RoboticsClubIITJ/painting-arm/Comparison/Result.png

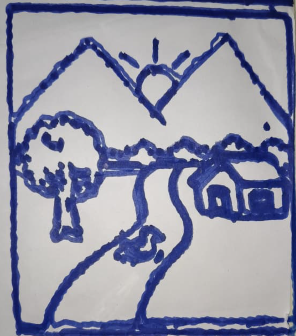
Comparison/Result.png
