RoboticsClubIITJ/painting-arm/Comparison/Original.png

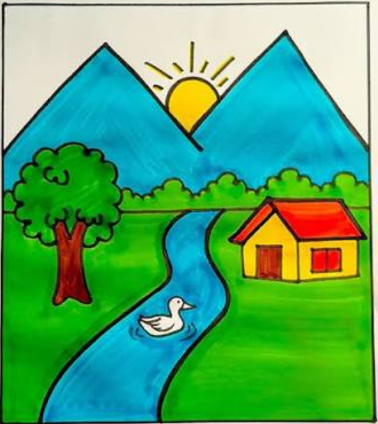
Comparison/Original.png
