RoboticsClubIITJ/painting-arm/Comparison/GUI.png

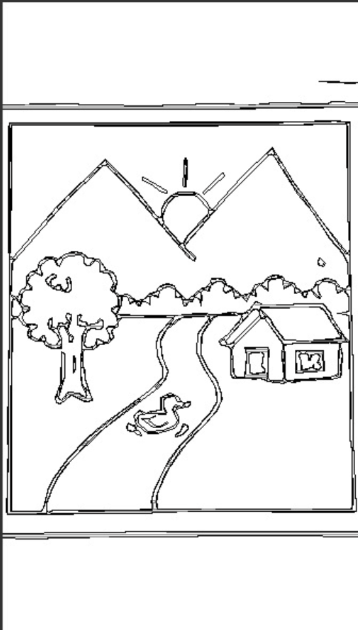
Comparison/GUI.png
