RoboticsClubIITJ/painting-arm/CAD Model/BoBRoss Assembly.step

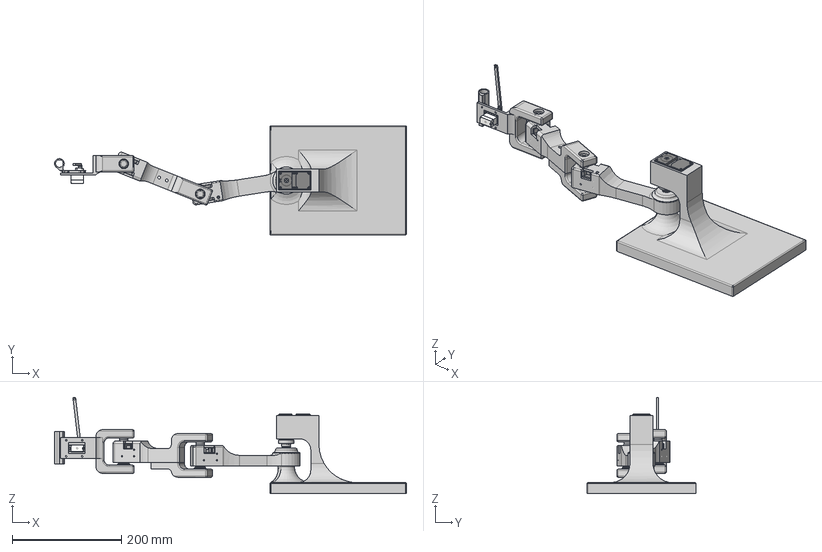
[picture p8: CAD file, 2026-10-04]
CAD Model/BoBRoss Assembly.step
644.3 x 200.0 x 175.9 mm
