RoboticsClubIITJ/painting-arm/CAD Model/Printables/link2p2.stl

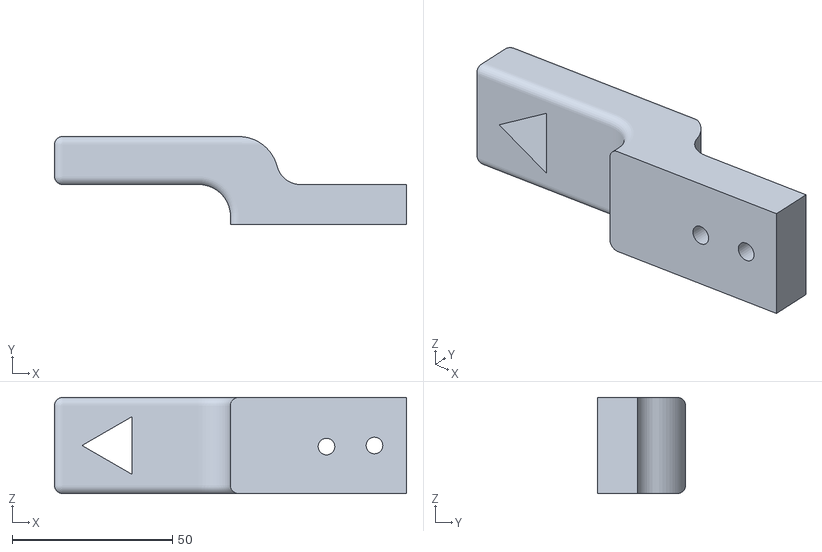
[picture p9: CAD file, 2026-10-04]
CAD Model/Printables/link2p2.stl
110.0 x 27.5 x 30.0
