RoboticsClubIITJ/painting-arm/CAD Model/Printables/Servo_head_xm430.stl

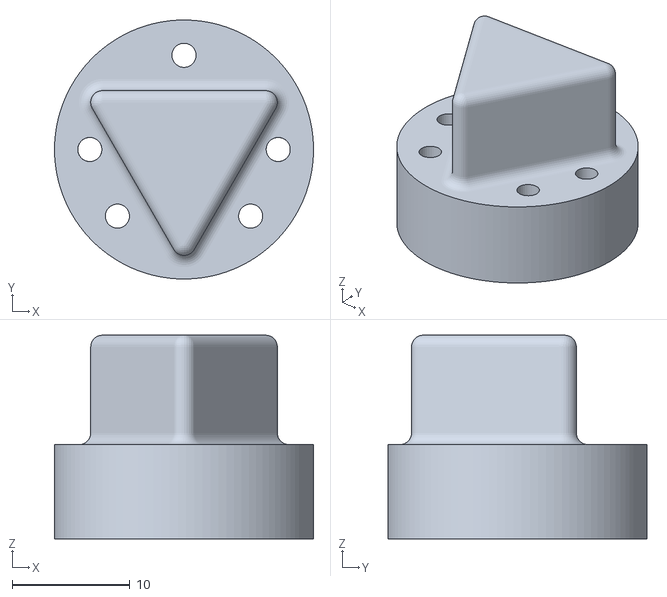
[picture p10: CAD file, 2026-10-04]
CAD Model/Printables/Servo_head_xm430.stl
22.0 x 22.0 x 17.3
