RoboticsClubIITJ/painting-arm/CAD Model/Printables/end effector.stl

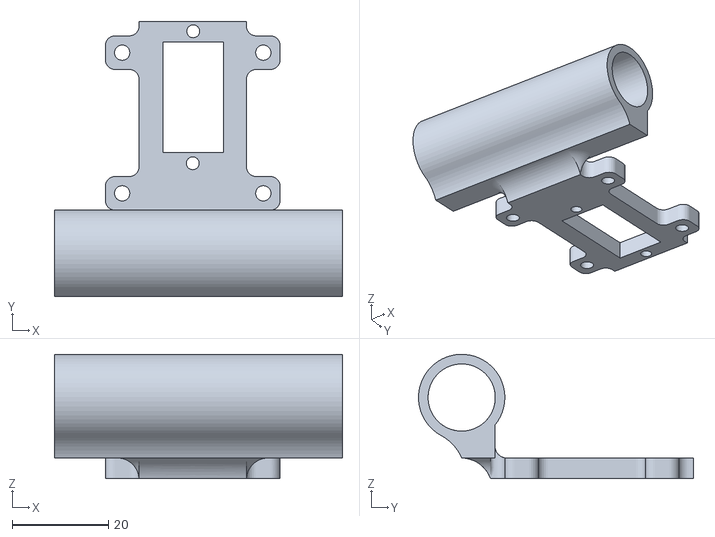
[picture p11: CAD file, 2026-10-04]
CAD Model/Printables/end effector.stl
60.0 x 57.3 x 25.9
