RoboticsClubIITJ/painting-arm/CAD Model/Printables/servo head.stl

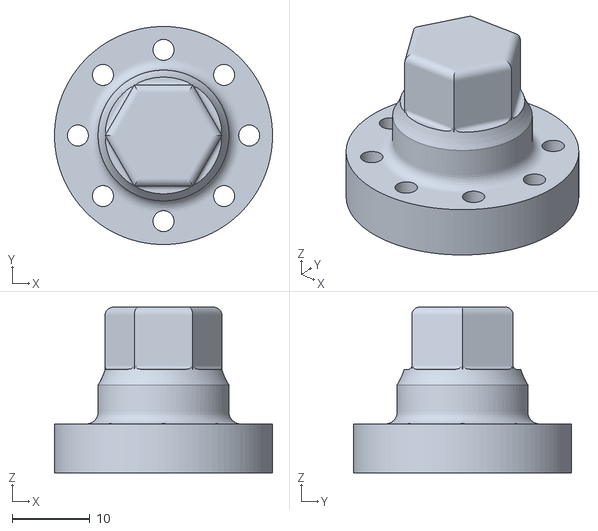
[picture p12: CAD file, 2026-10-04]
CAD Model/Printables/servo head.stl
28.0 x 28.0 x 21.3
