RoboticsClubIITJ/painting-arm/CAD Model/Printables/link2p1.stl

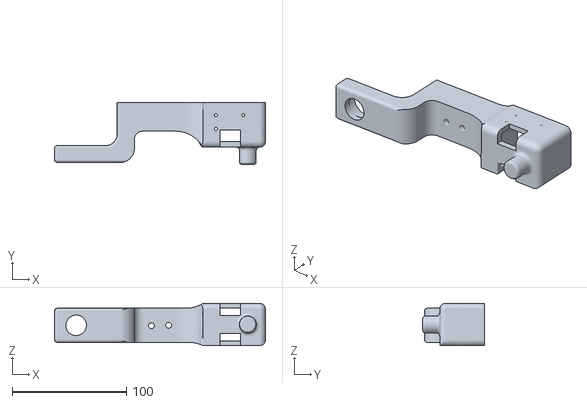
[picture p13: CAD file, 2026-10-04]
CAD Model/Printables/link2p1.stl
185.0 x 54.0 x 37.0
