RoboticsClubIITJ/painting-arm/CAD Model/Printables/base2.stl

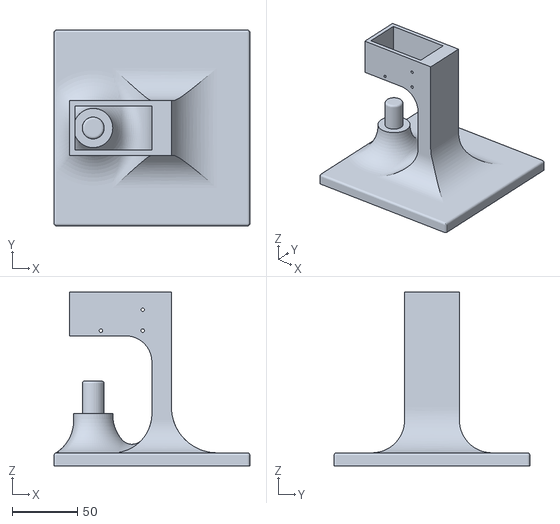
[picture p14: CAD file, 2026-10-04]
CAD Model/Printables/base2.stl
150.0 x 150.0 x 133.0
