RoboticsClubIITJ/painting-arm/CAD Model/Printables/link3p1.stl

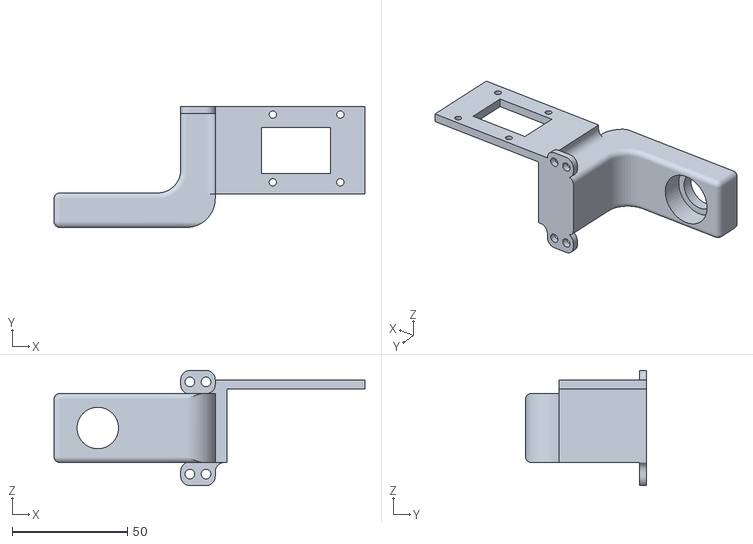
[picture p15: CAD file, 2026-10-04]
CAD Model/Printables/link3p1.stl
135.0 x 52.5 x 50.0
