RoboticsClubIITJ/painting-arm/CAD Model/Printables/link1.stl

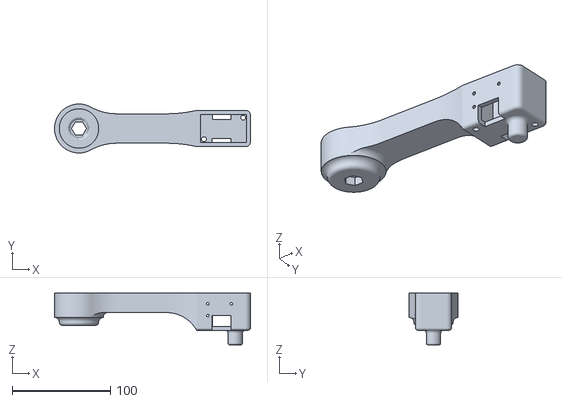
[picture p16: CAD file, 2026-10-04]
CAD Model/Printables/link1.stl
200.0 x 50.0 x 53.0
