RoboticsClubIITJ/painting-arm/CAD Model/Printables/link3p2.stl

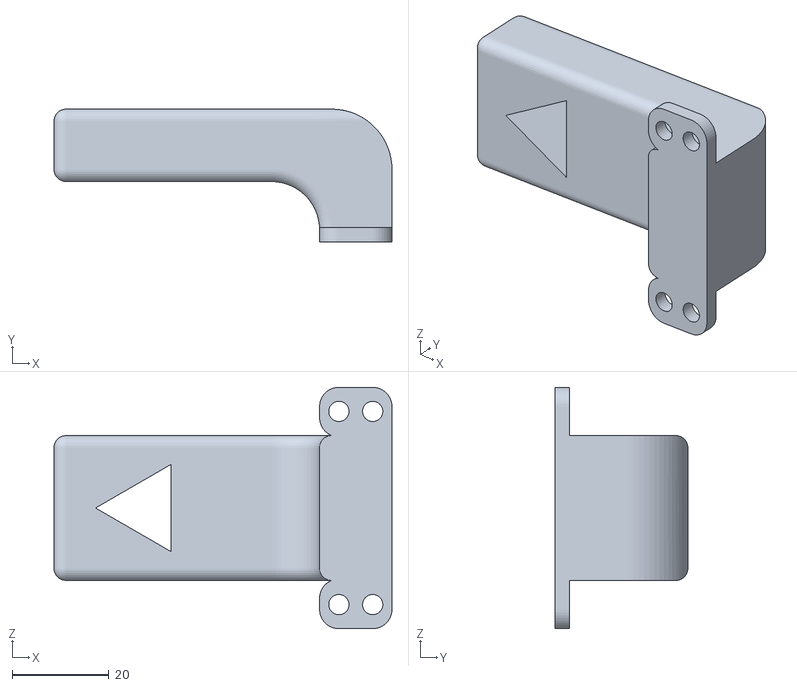
[picture p17: CAD file, 2026-10-04]
CAD Model/Printables/link3p2.stl
70.0 x 27.5 x 50.0
