RoboticsClubIITJ/painting-arm/(list of files, cad)

Other CAD files:
CAD Model/BoBRoss Assembly.f3z
