RoboticsClubIITJ/painting-arm/GradientDescentBasedIK.pdf

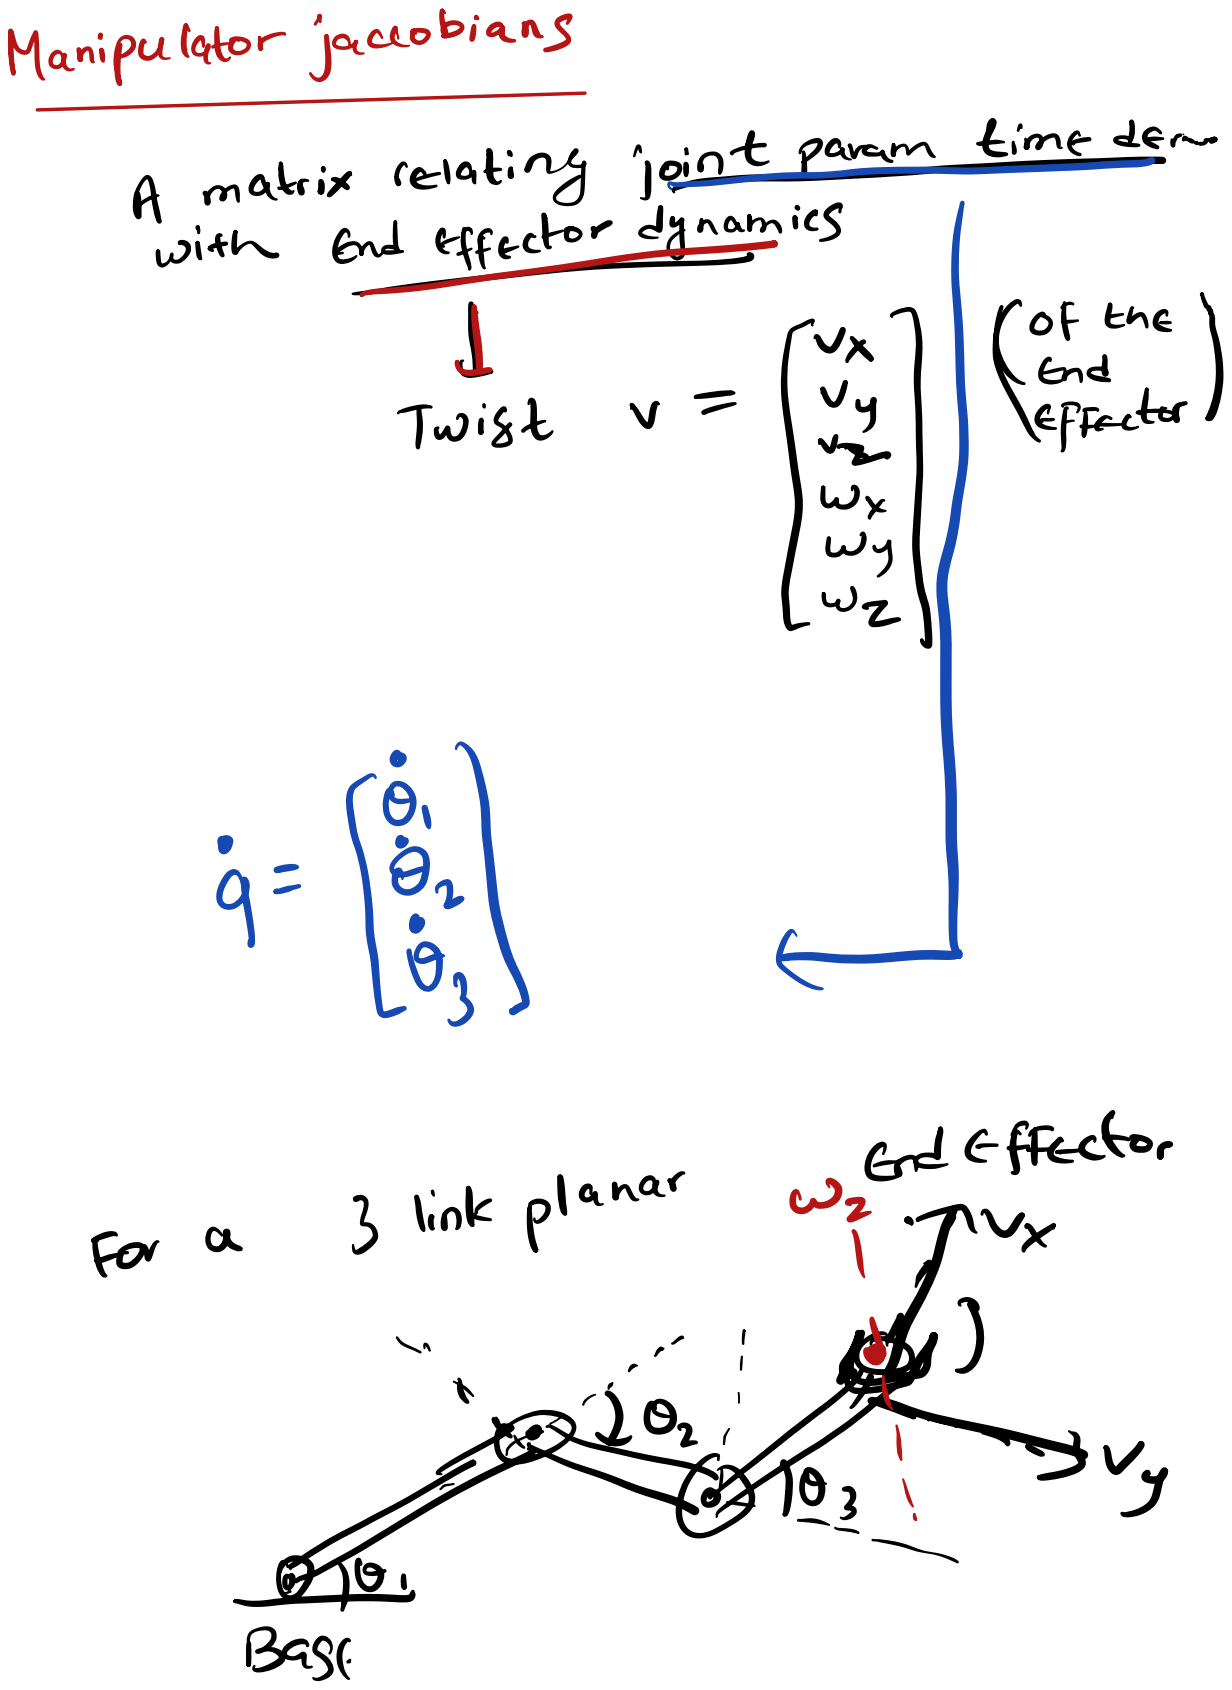
[picture p18: page 1]

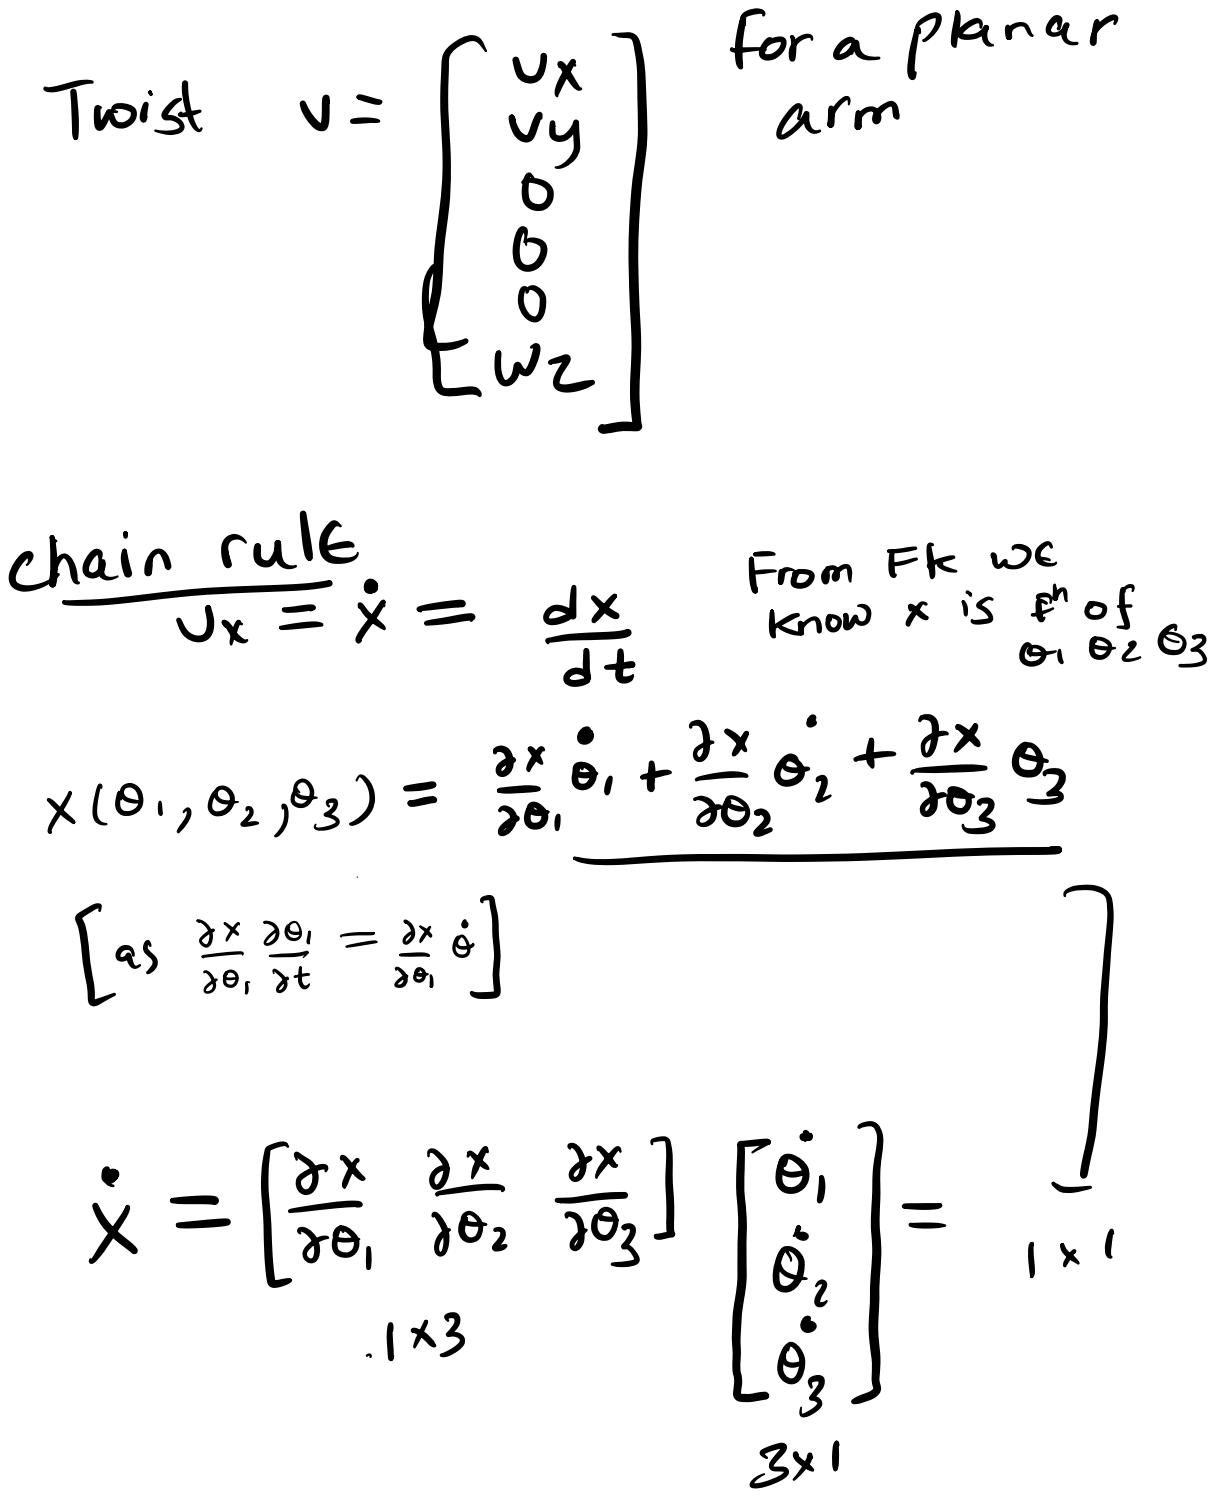
[picture p19: page 2]

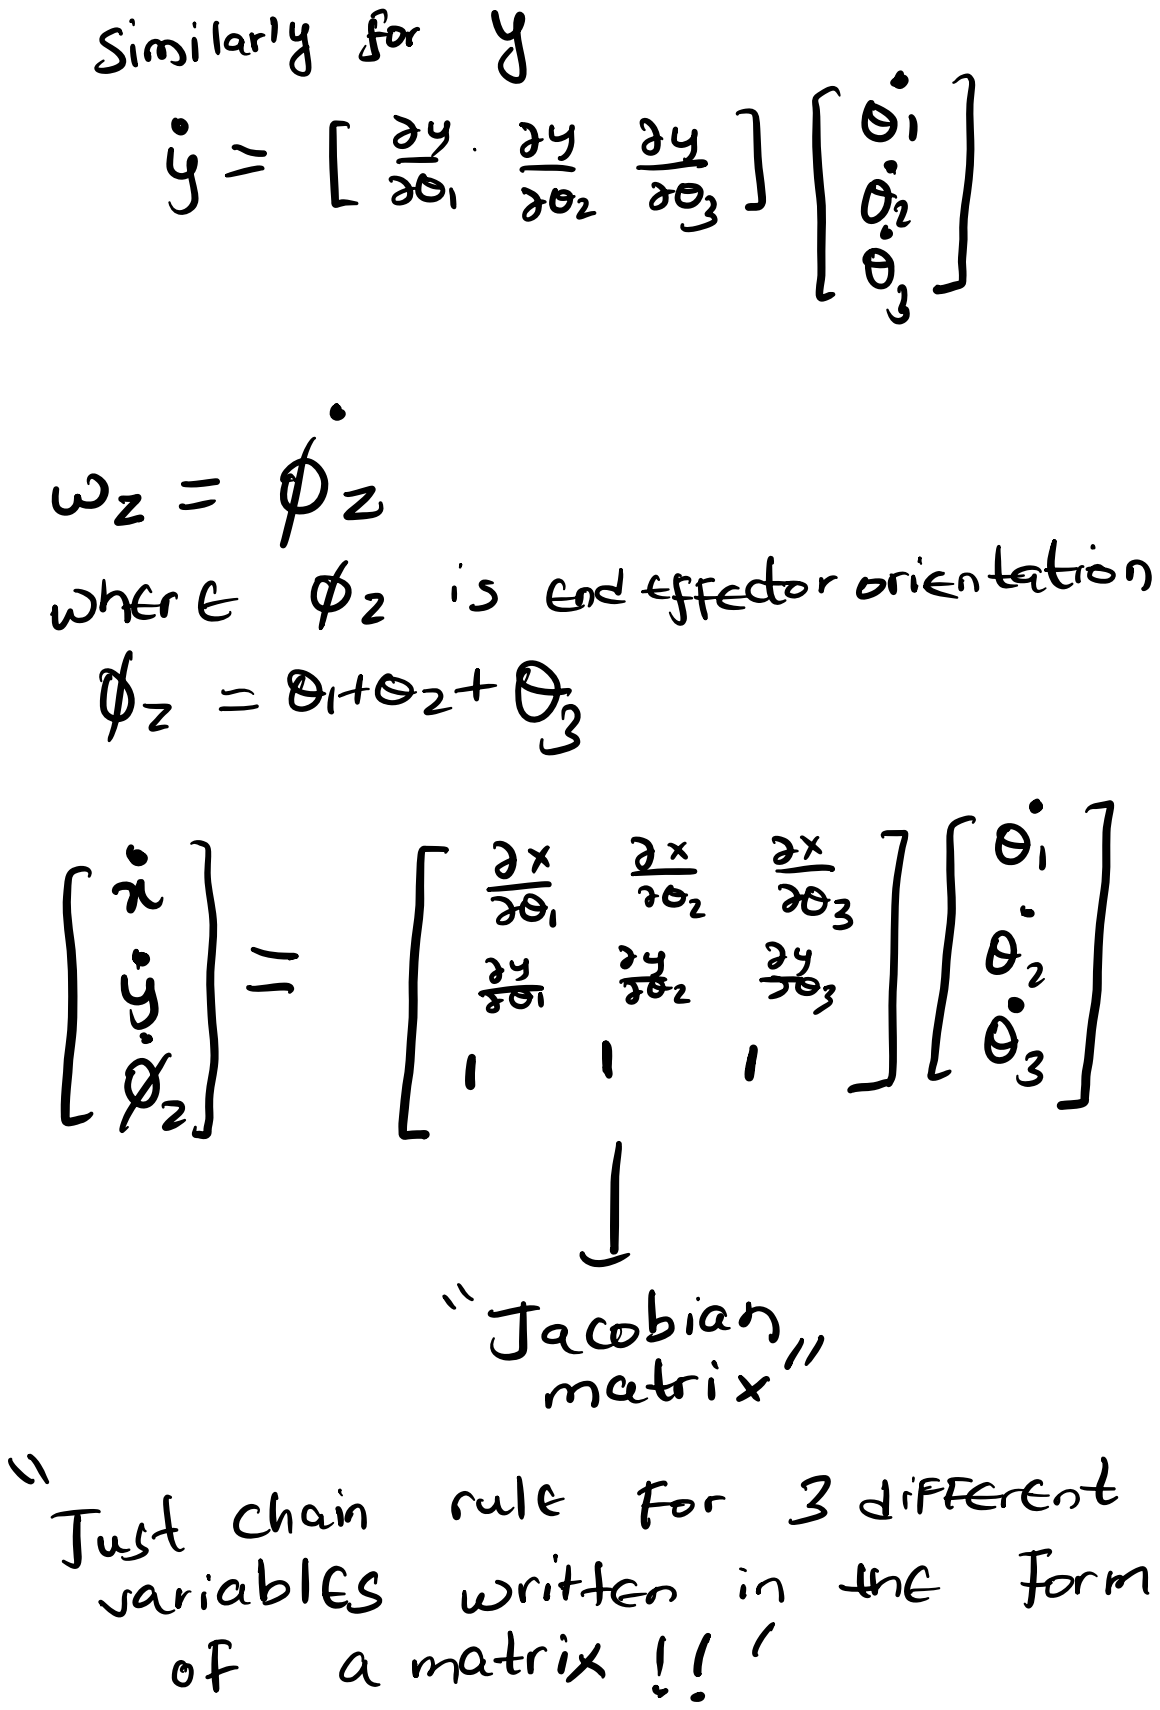
[picture p20: page 3]

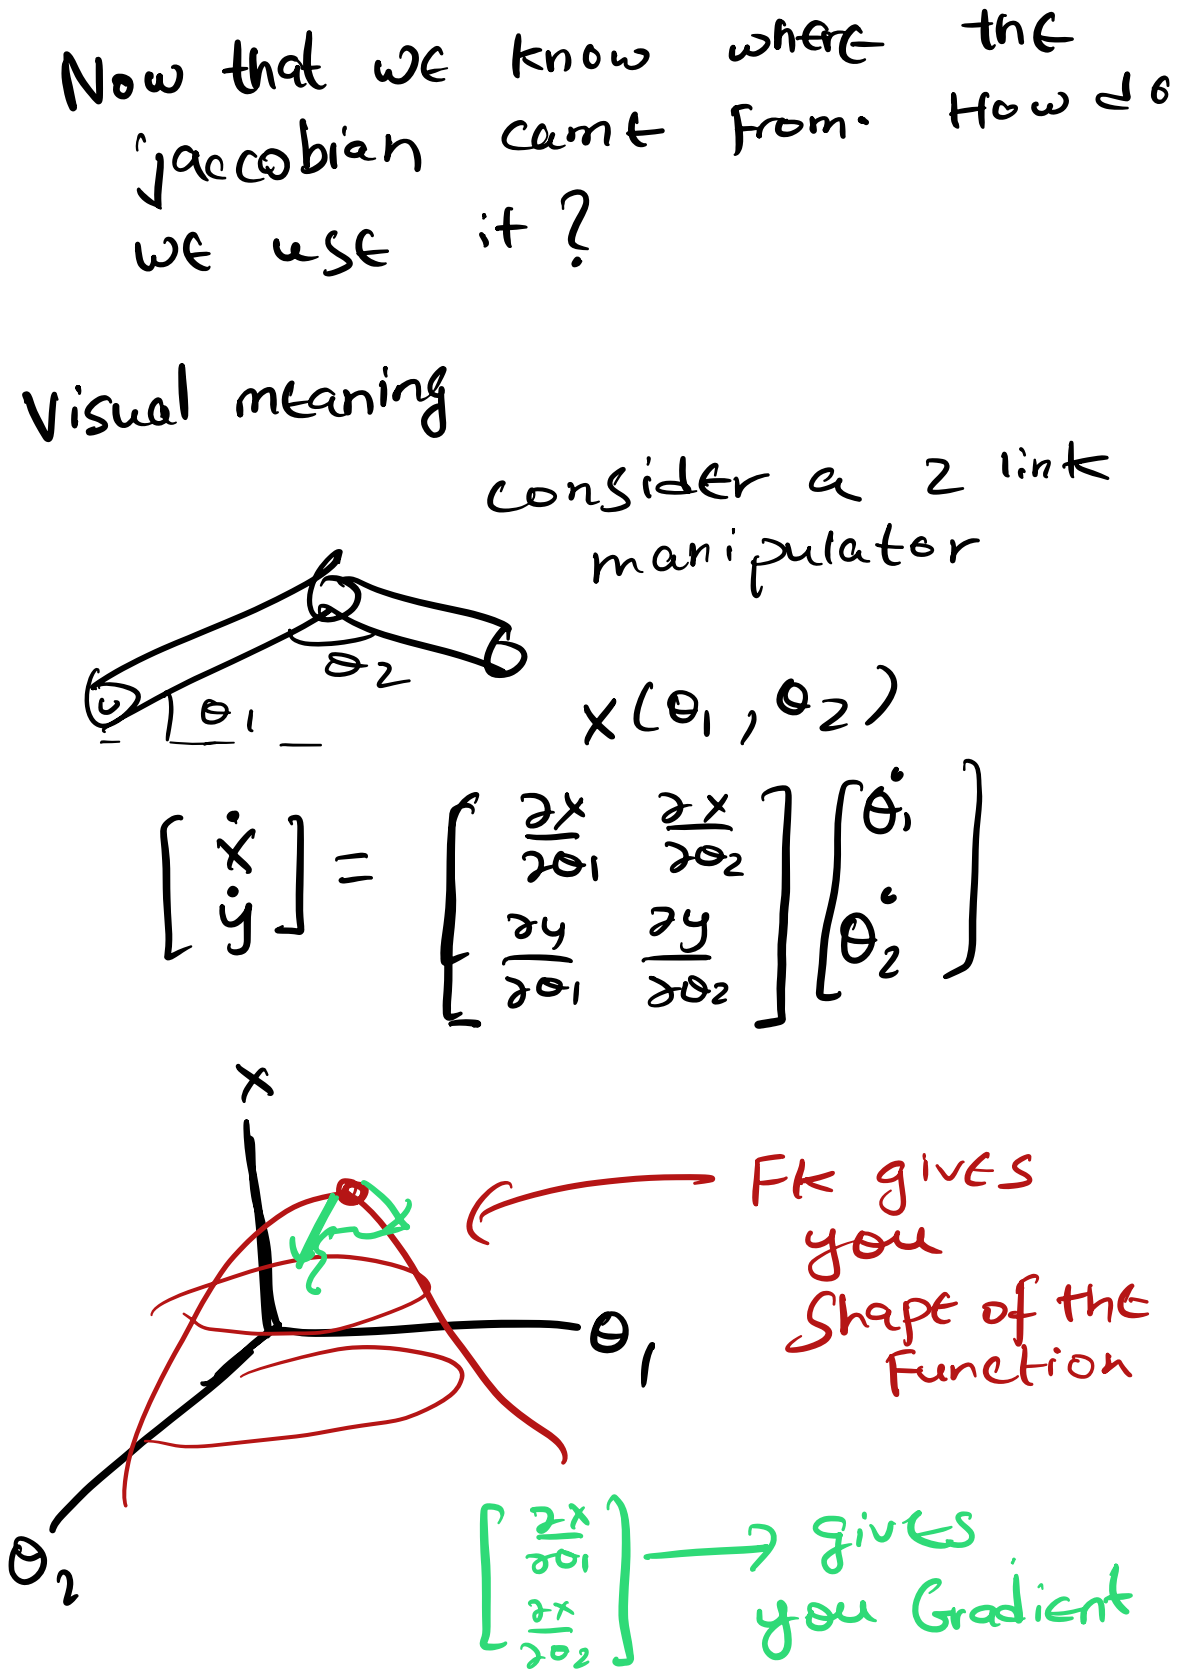
[picture p21: page 4]

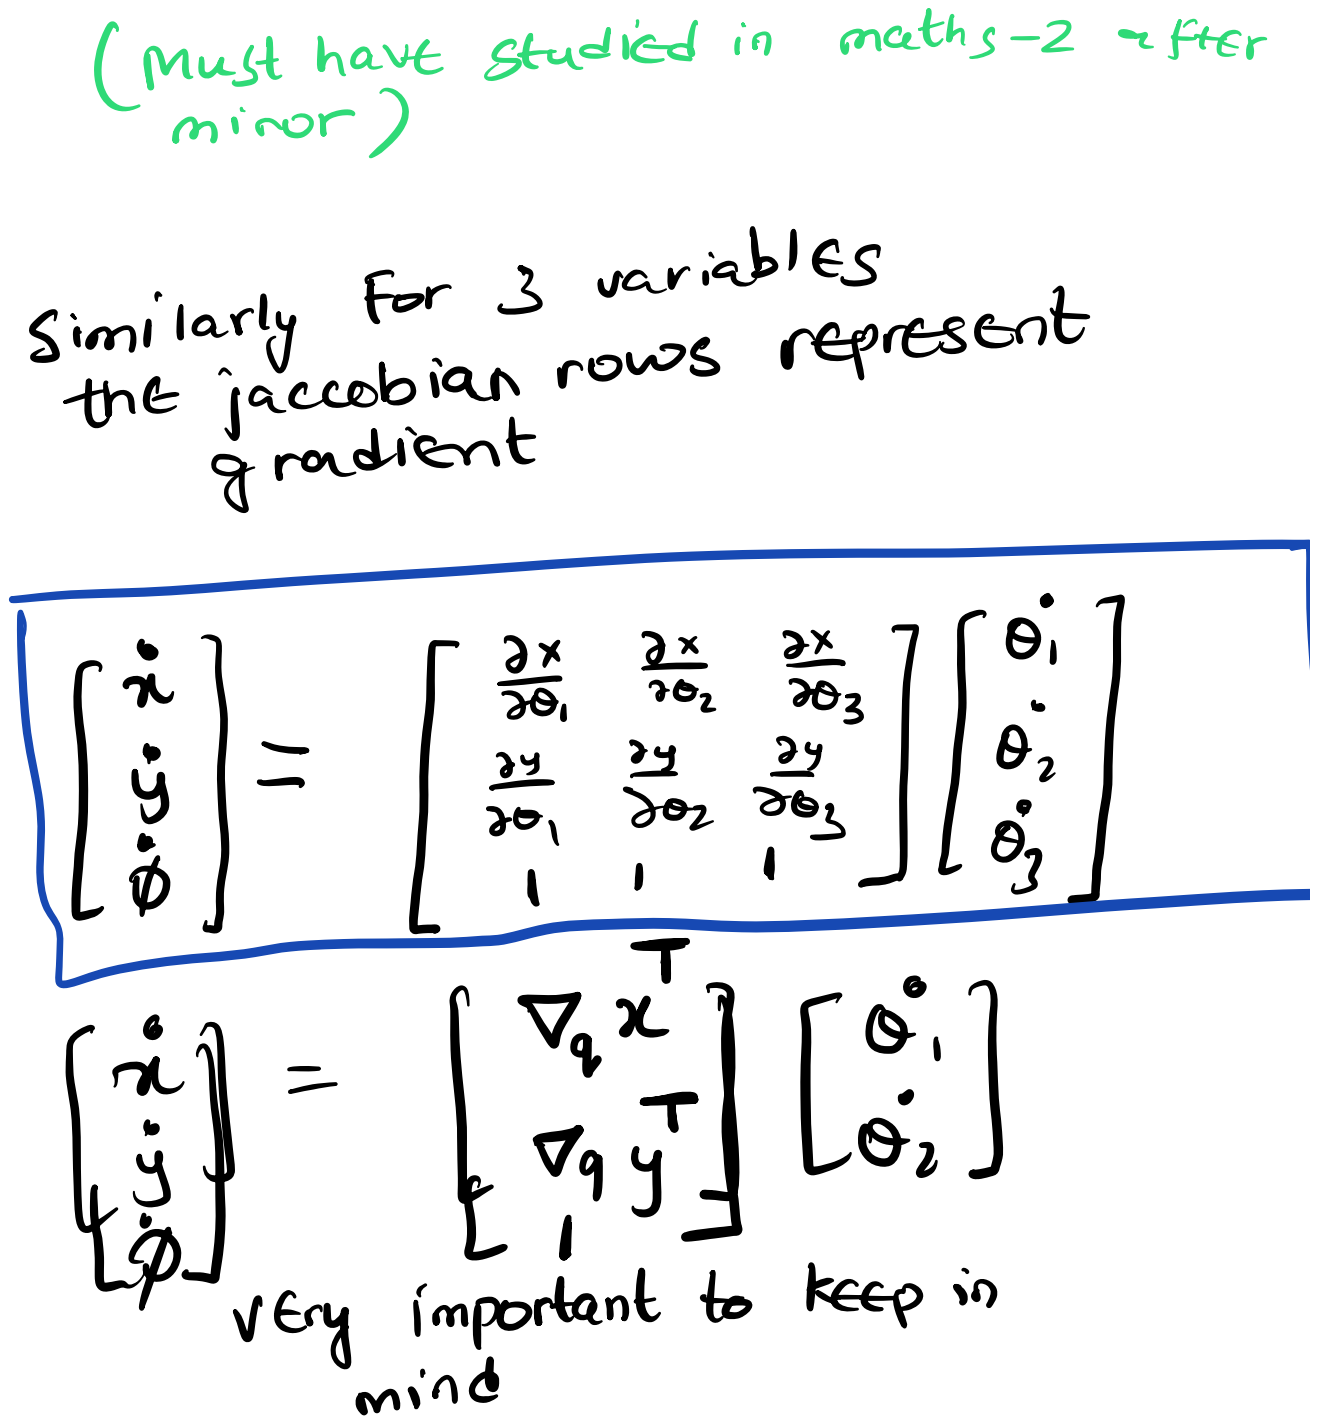
[picture p22: page 5]

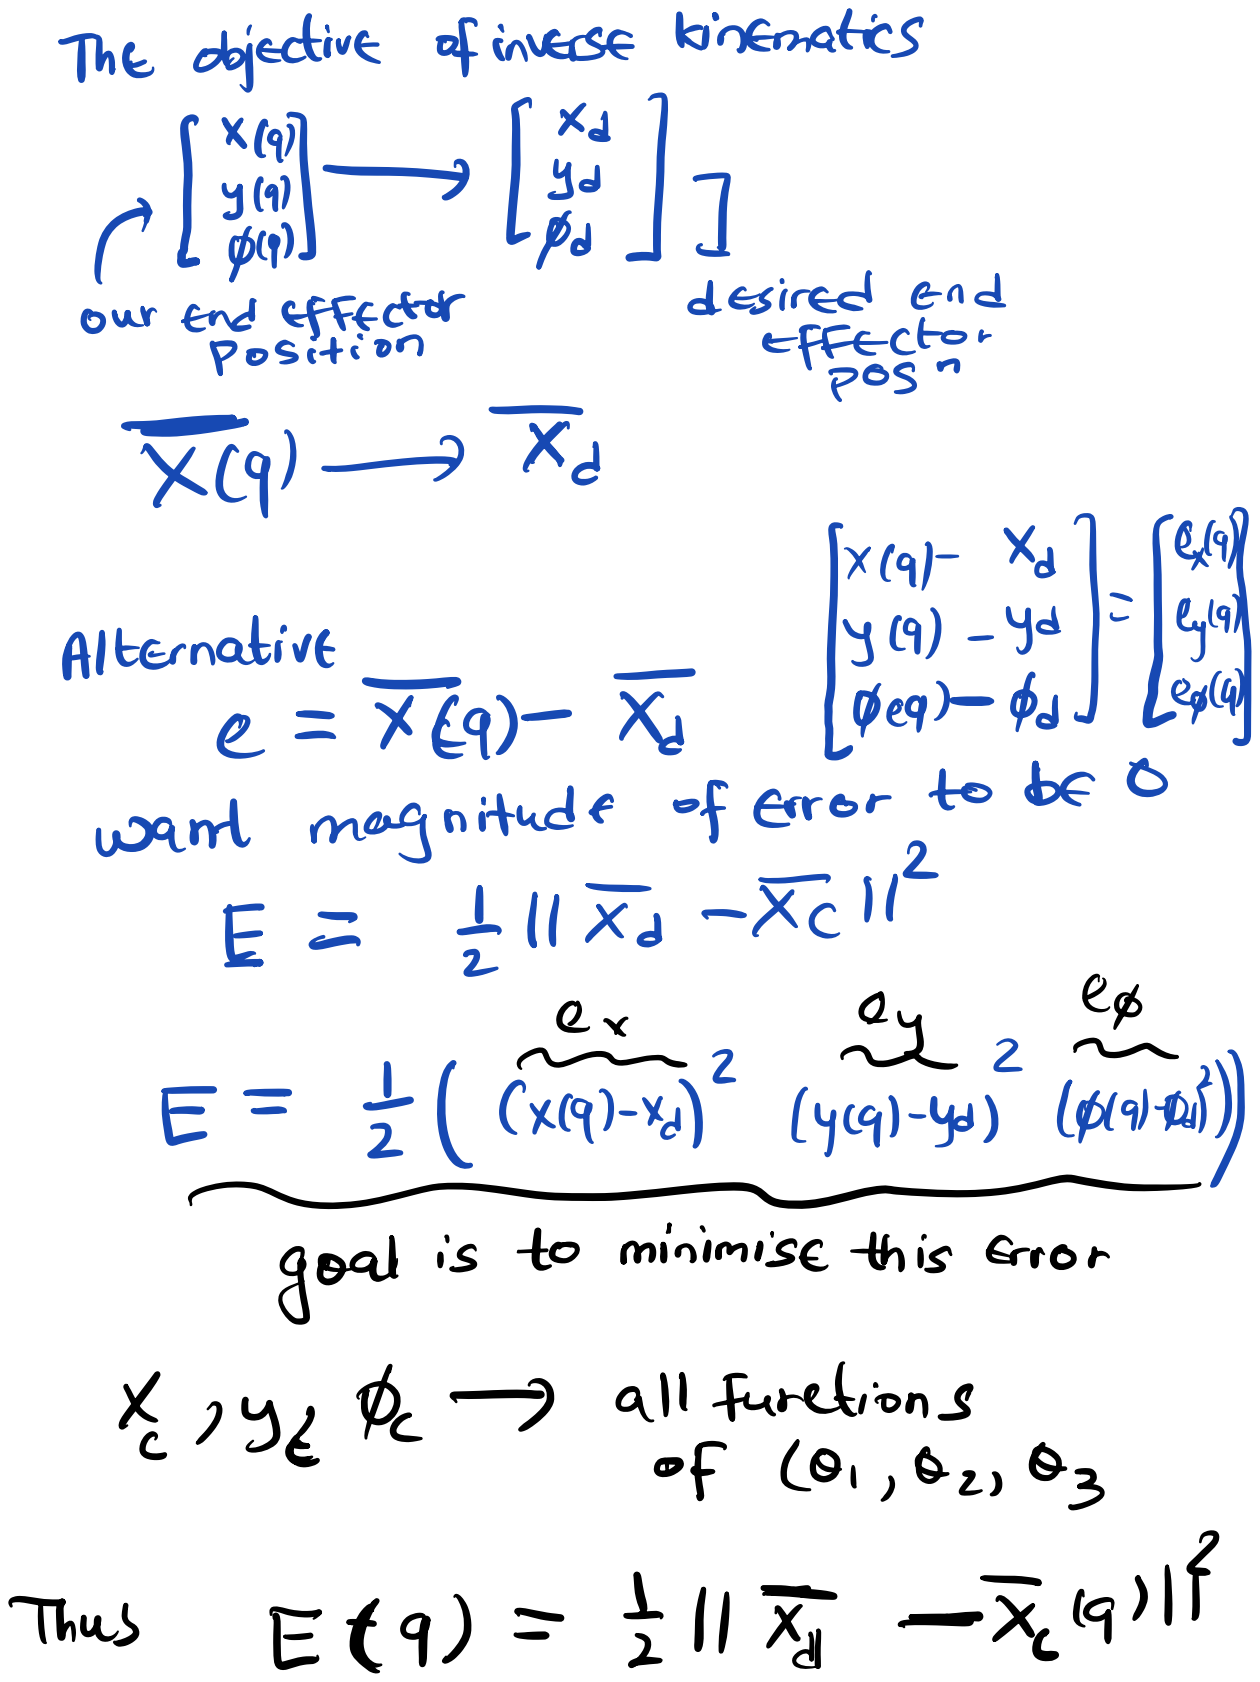
[picture p23: page 6]

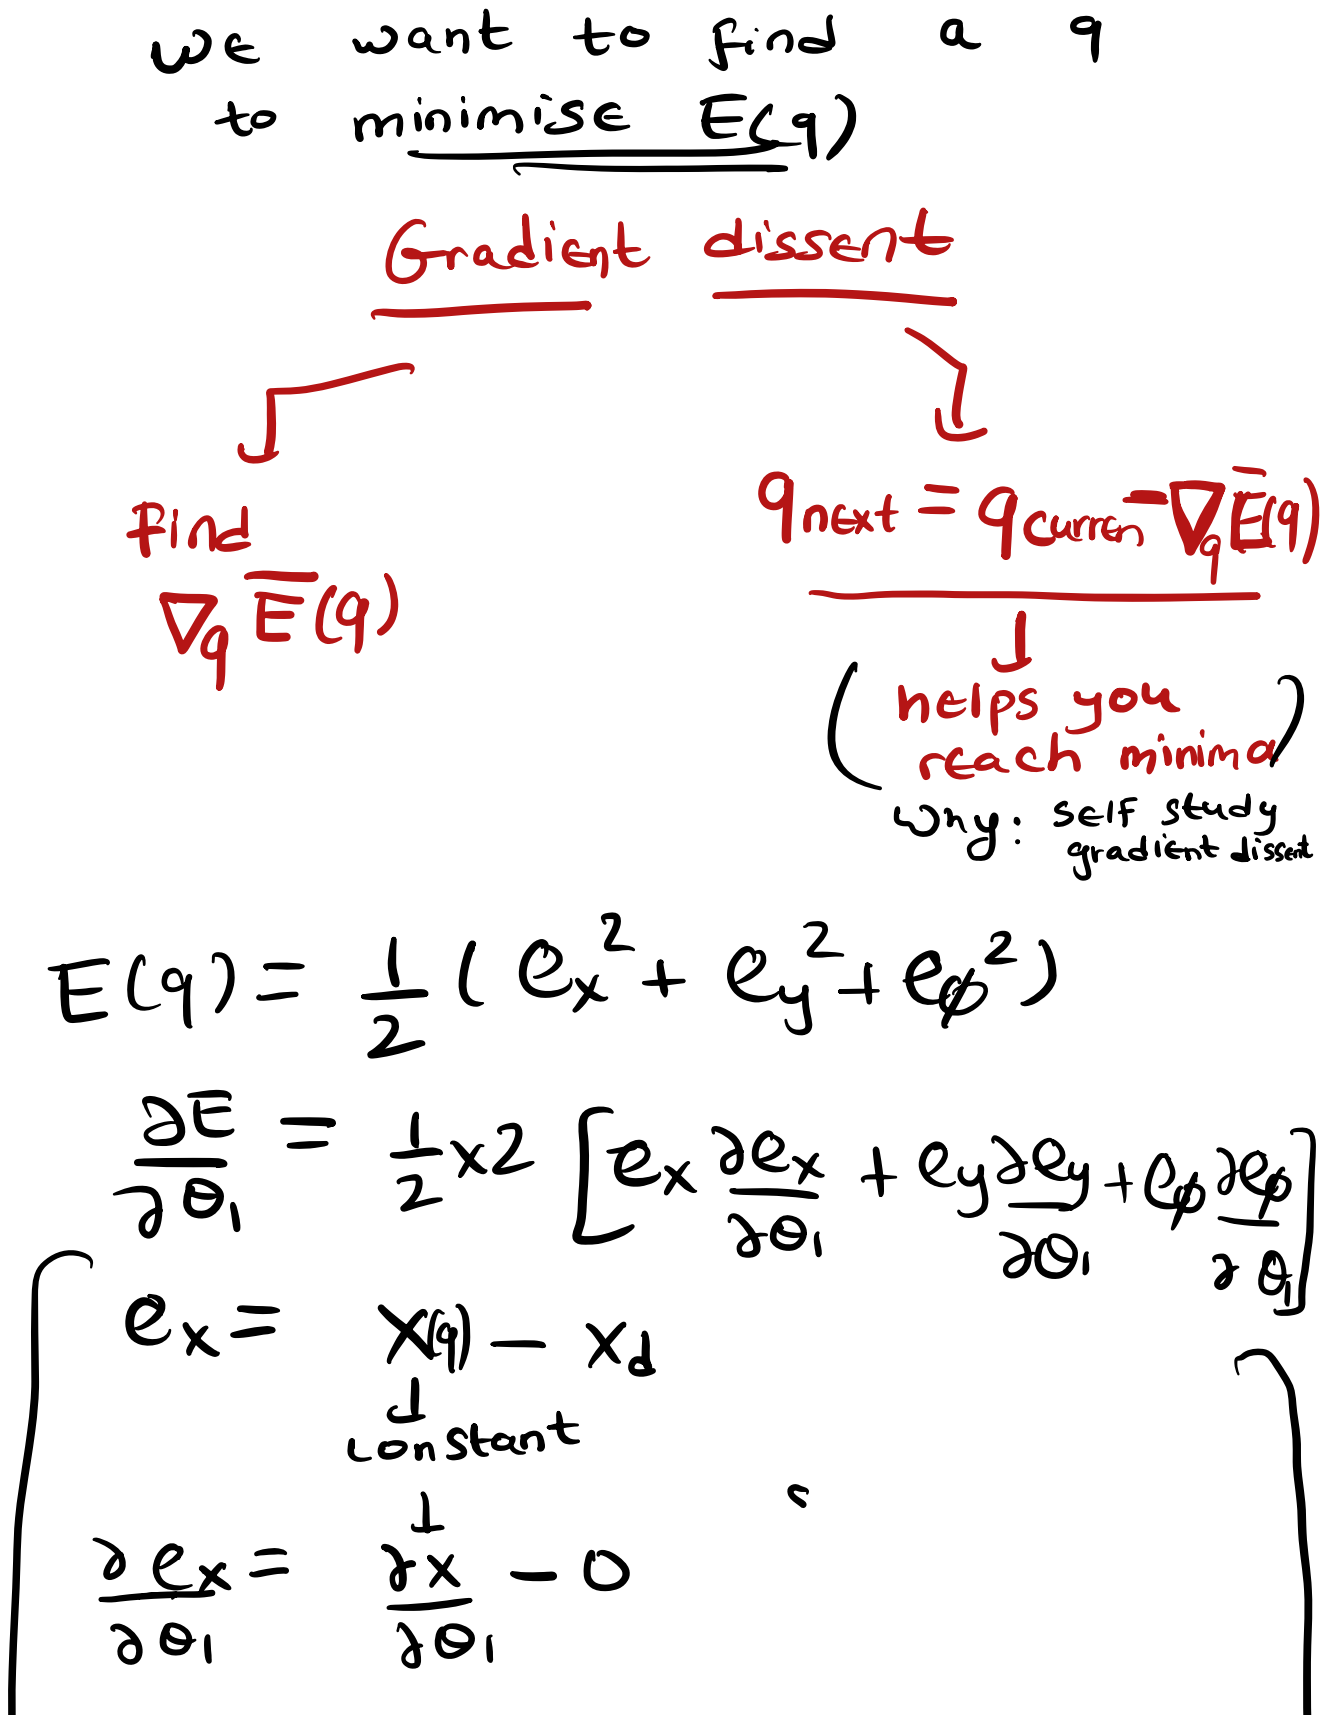
[picture p24: page 7]

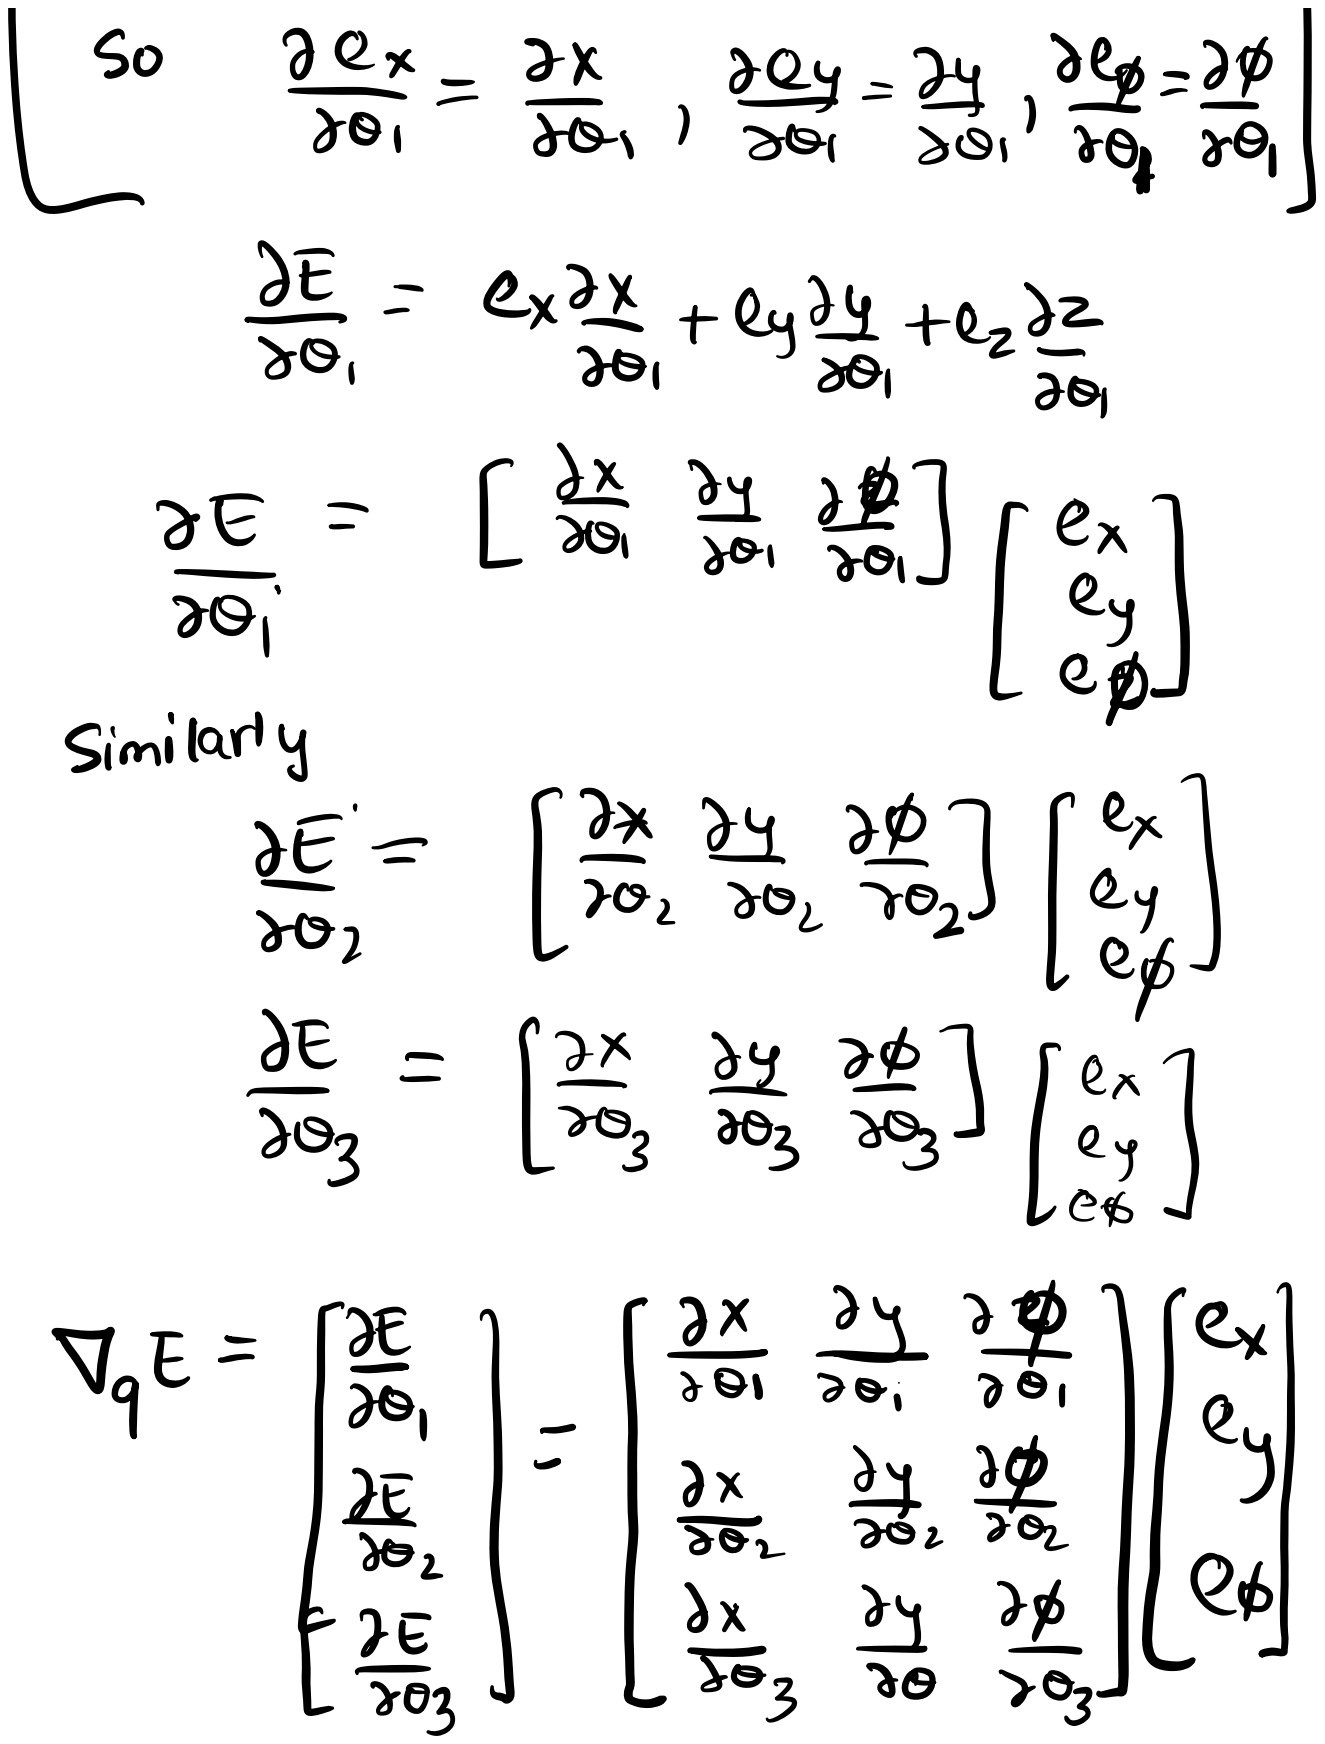
[picture p25: page 8]

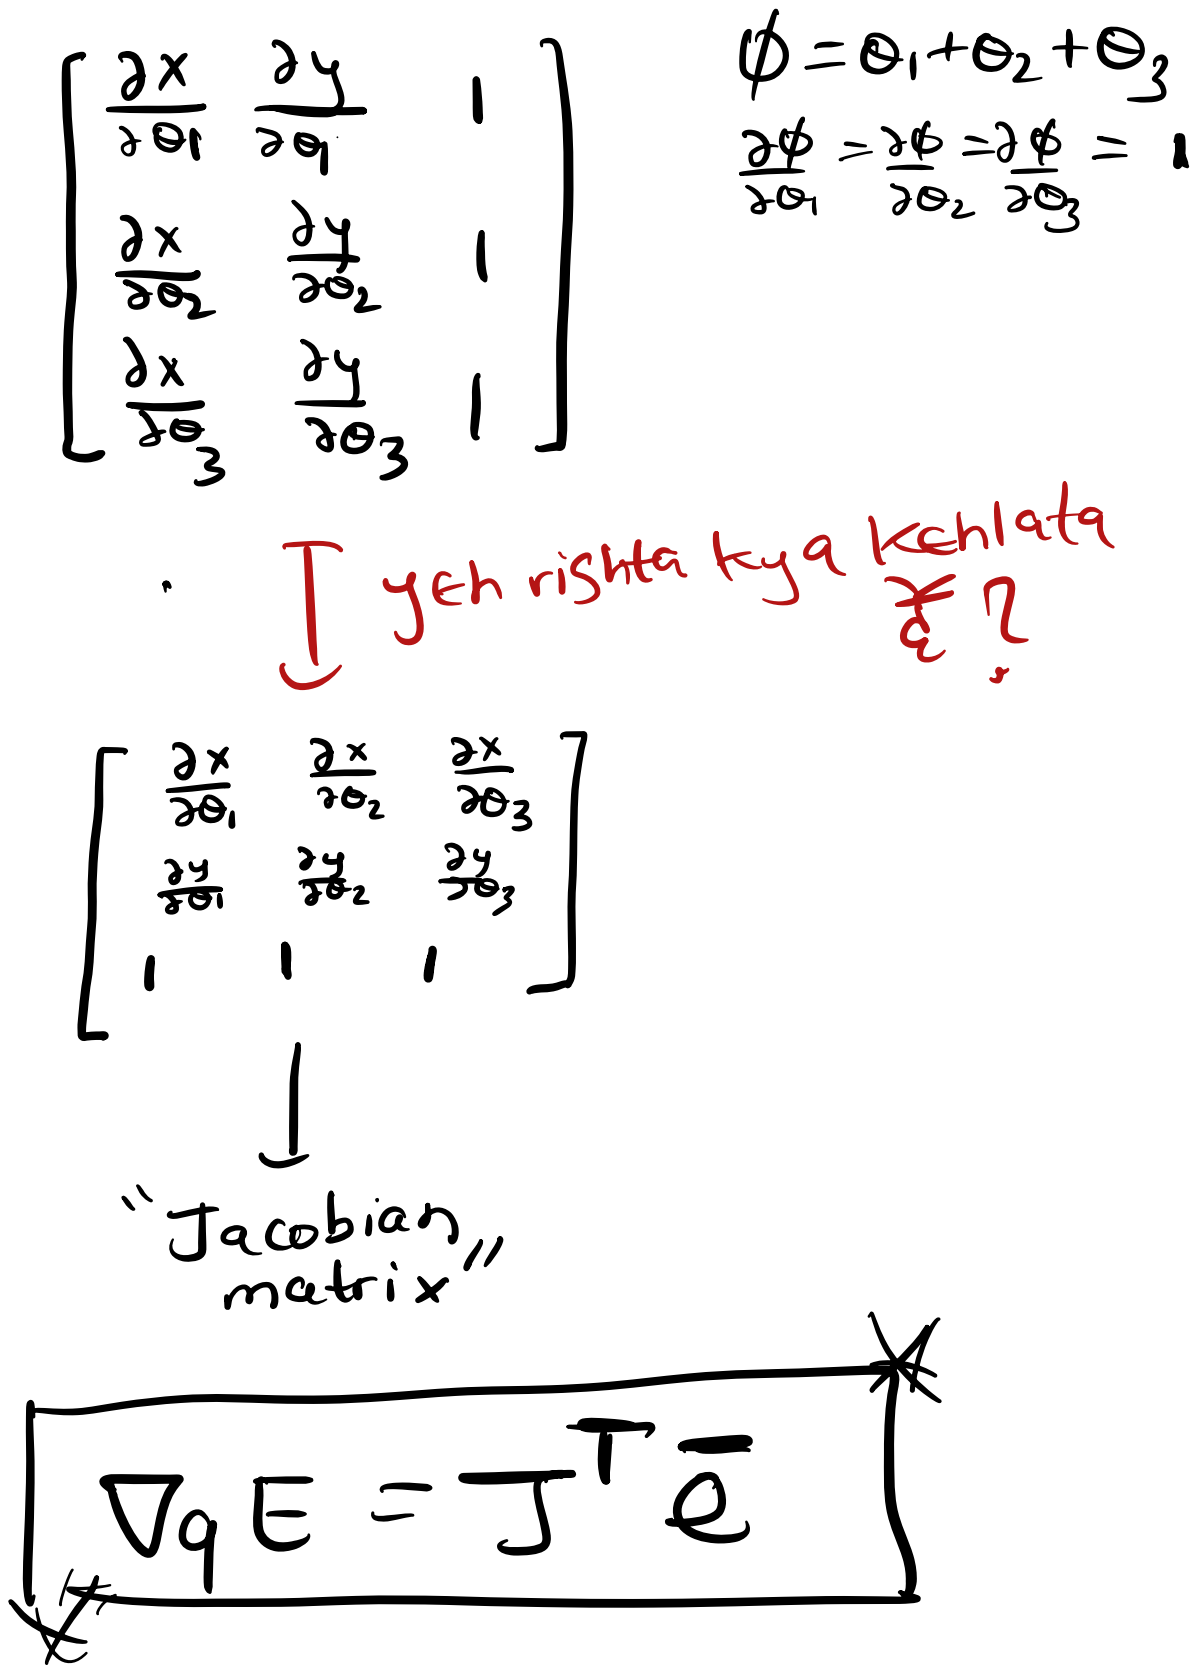
[picture p26: page 9]

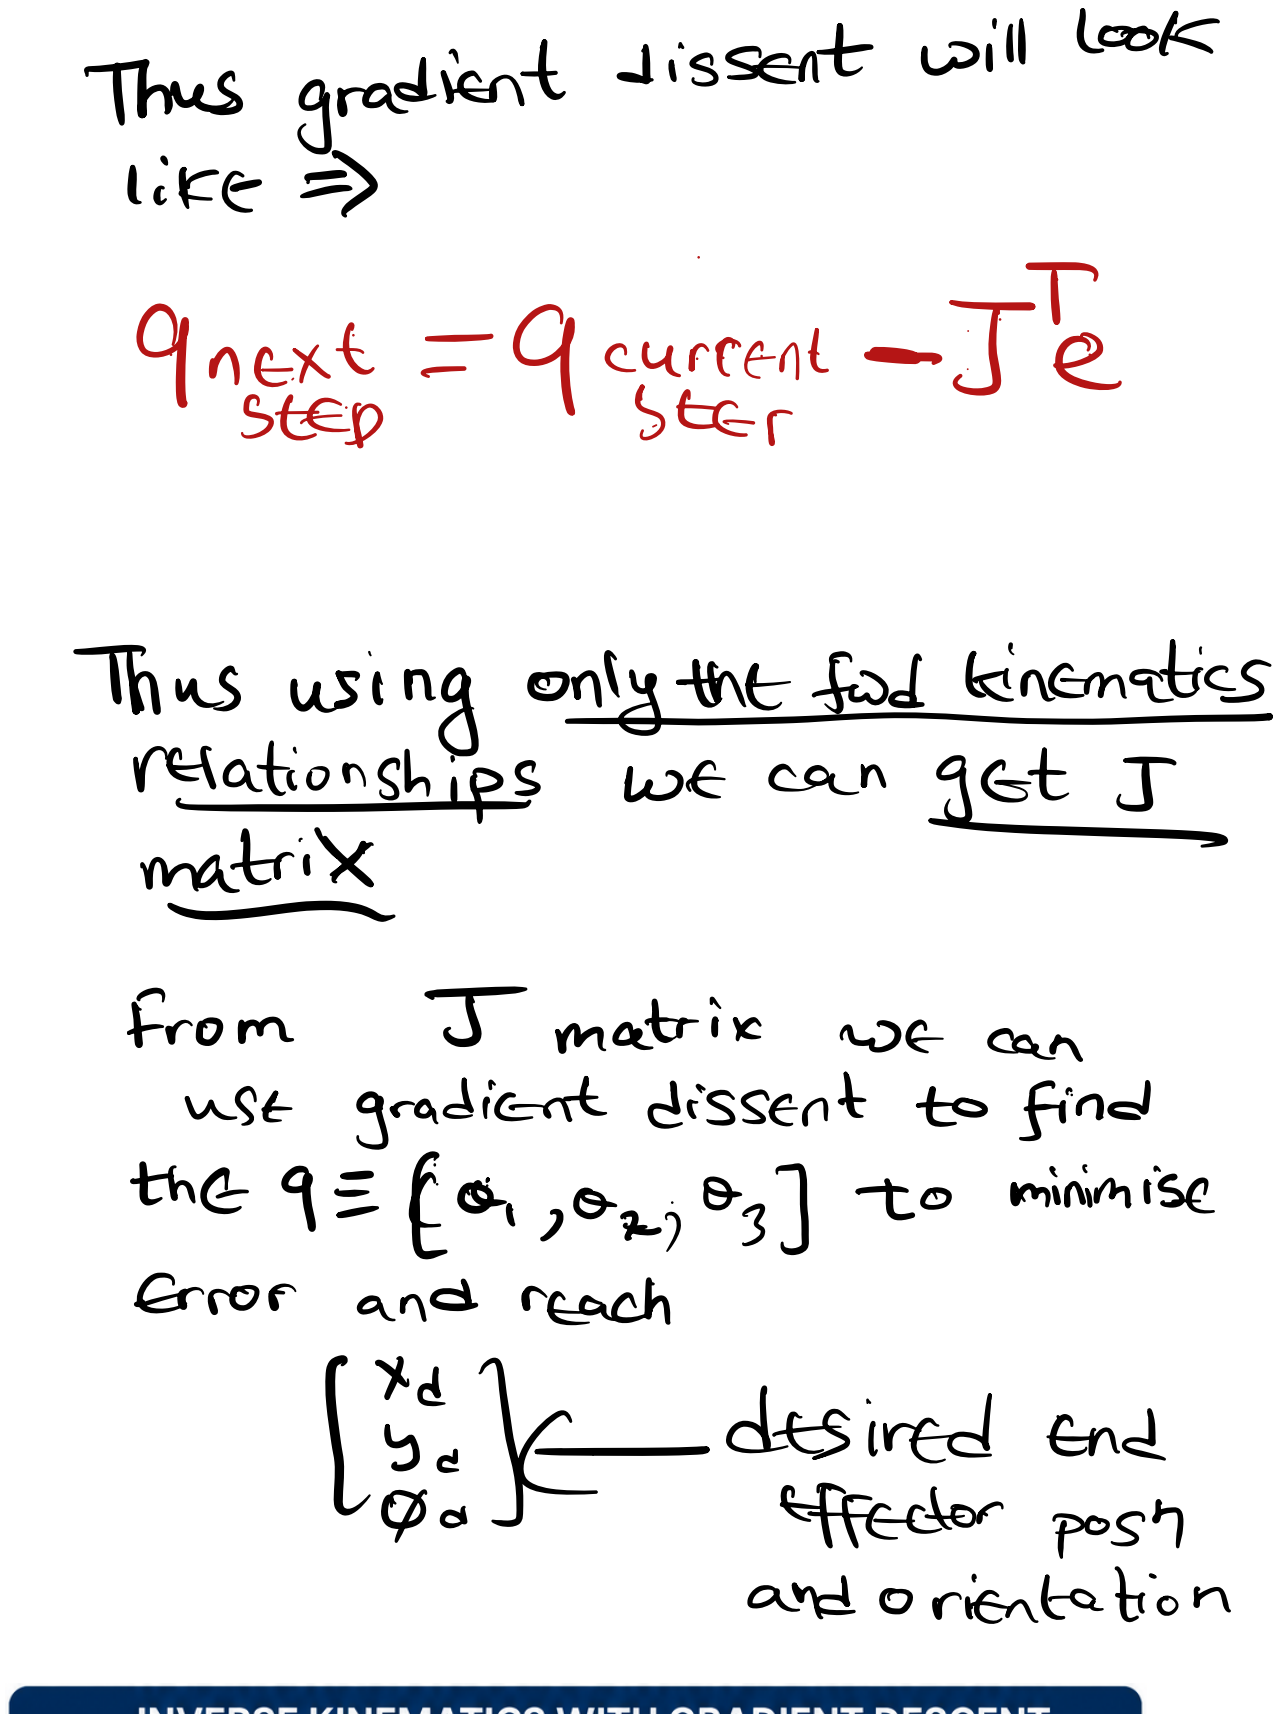
[picture p27: page 10]

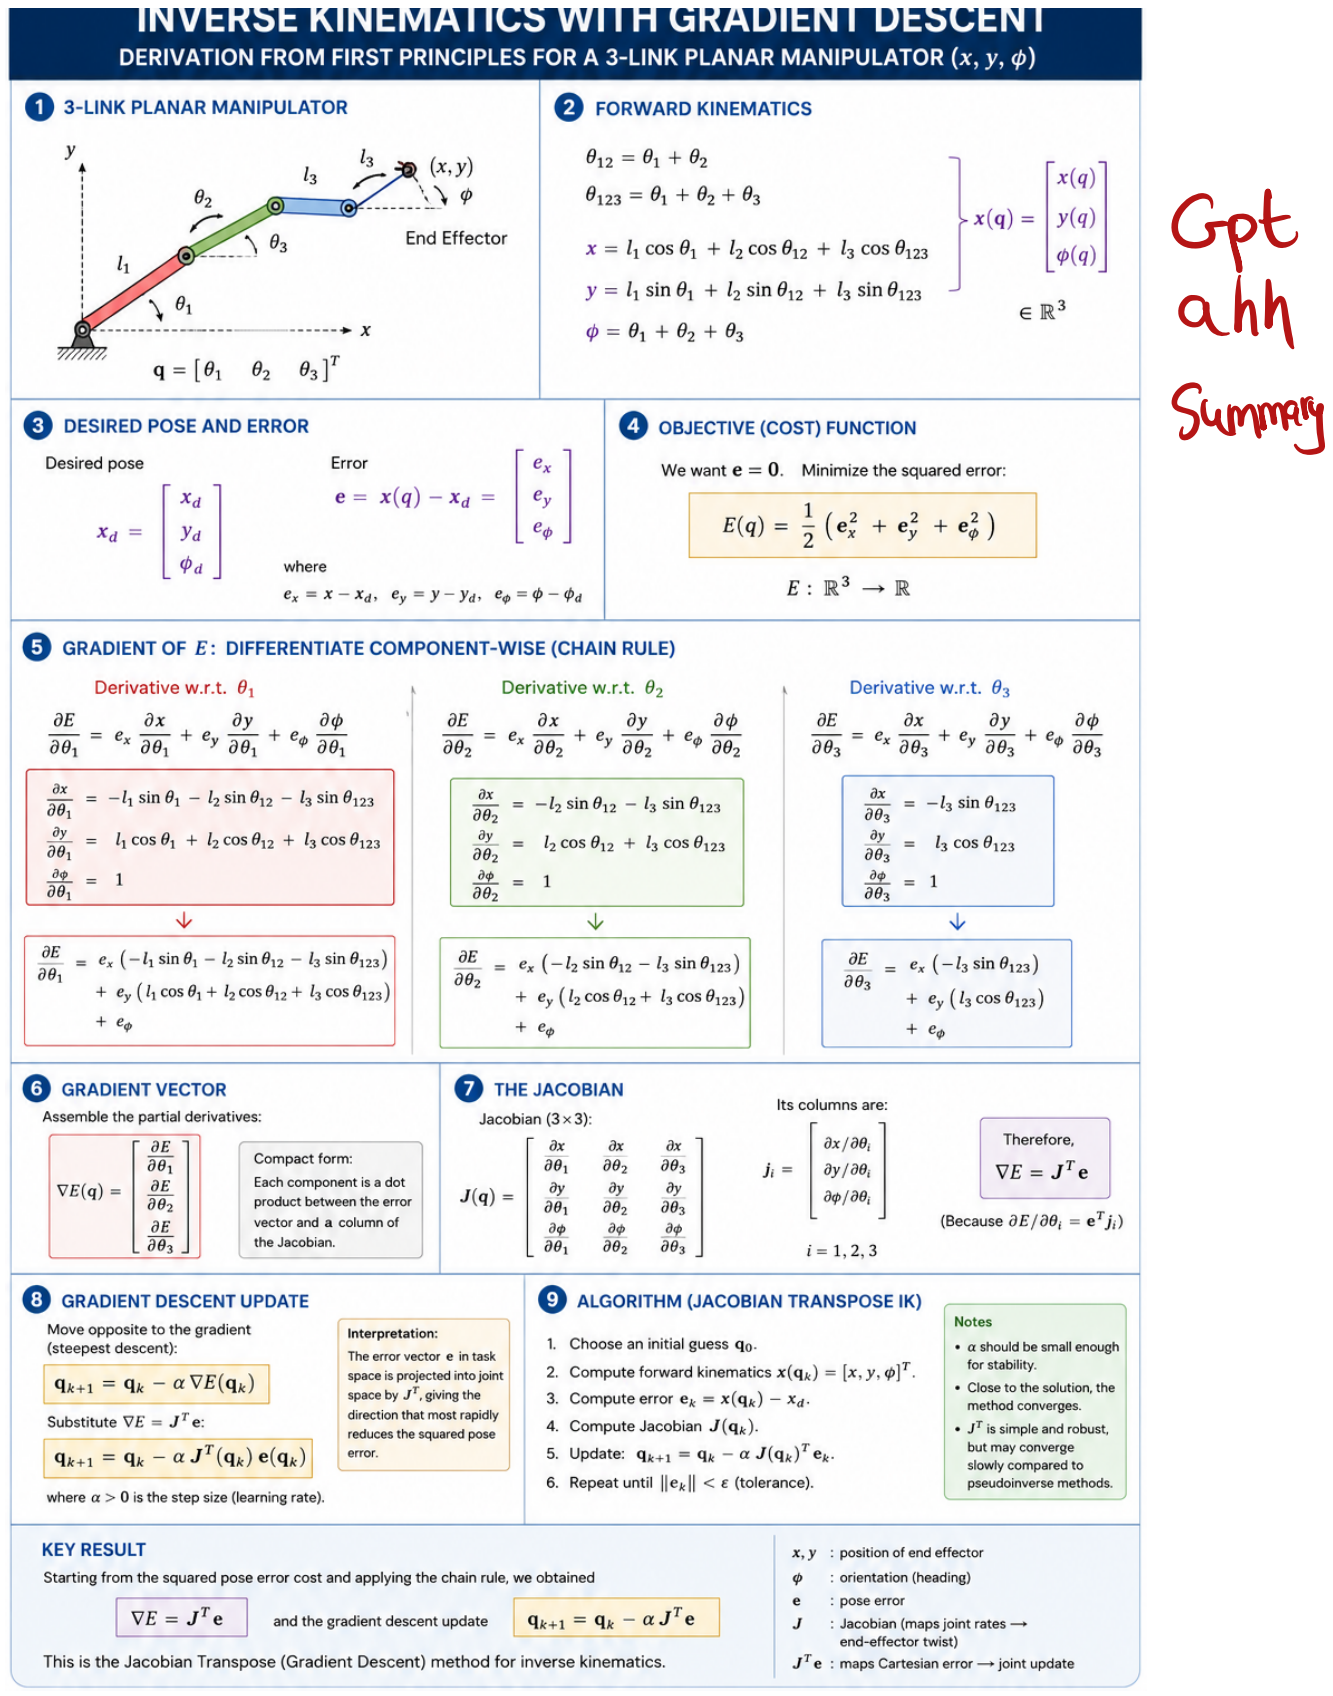
[picture p28: page 11]
