RoboticsClubIITJ/painting-arm/BobRoss/cv.py

"""
Image -> drawable-path pipeline using XDoG for detailed drawings/portraits.

Pipeline:
1. Preprocess: Bilateral filter -> XDoG
2. Binarize: Otsu threshold
3. Clean: Remove small connected components
4. Extract: Contours -> RDP simplification -> B-spline smoothing
5. Map: Scale/recenter into the robot's physical drawing workspace
"""

import numpy as np
import cv2
from scipy.interpolate import splprep, splev
from Configurations import (
    MIN_CONTOUR_ARC_LEN,
    MIN_CONTOUR_POINTS,
    SPLINE_SMOOTHING,
    APPROX_POLY_EPSILON,
    TARGET_CANVAS_W,
    TARGET_CANVAS_H,
    CANVAS_CENTER_X,
    CANVAS_CENTER_Y,
)


class AnnotatedPath(list):
    """Behaves like a normal coordinate list, but attaches an 'is_hatch' attribute for the GUI."""
    def __init__(self, iterable, is_hatch=False):
        super().__init__(iterable)
        self.is_hatch = is_hatch


def xdog_filter(image, sigma=1.4, k_sigma=1.6, epsilon=0.01, phi=20, gamma=0.98):
    """
    Extended Difference-of-Gaussians (XDoG).

    Produces a sketch-like grayscale image emphasizing dark line
    structures and fine details.
    """
    if image.ndim == 3:
        gray = cv2.cvtColor(image, cv2.COLOR_BGR2GRAY)
    else:
        gray = image.copy()

    clahe = cv2.createCLAHE(clipLimit=2.0, tileGridSize=(8, 8))
    cl_img = clahe.apply(gray)

    cl_img_f = cl_img.astype(np.float32) / 255.0

    g1 = cv2.GaussianBlur(cl_img_f, (0, 0), sigma)
    g2 = cv2.GaussianBlur(cl_img_f, (0, 0), sigma * k_sigma)

    dog = g1 - (gamma * g2)
    out = np.ones_like(dog)
    idx = dog < epsilon

    out[idx] = 1.0 + np.tanh(phi * (dog[idx] - epsilon))

    out = (out * 255).clip(0, 255).astype(np.uint8)
    return out


def automatic_parameters(image):
    if image.ndim == 3:
        gray = cv2.cvtColor(image, cv2.COLOR_BGR2GRAY)
    else:
        gray = image.copy()
    median = cv2.medianBlur(gray, 3)
    noise = float(np.mean(cv2.absdiff(gray, median))) / 255.0
    height, width = gray.shape
    scale = max(height, width) / 1000.0

    sigma = np.clip(1.1 * scale + 8.0 * noise, 1.1, 3.5)
    k_sigma = np.clip(4.3 + noise * 10.0, 2.5, 5.5)
    epsilon = np.clip(0.008 + noise * 0.20, 0.005, 0.08)
    phi = int(np.clip(30 + noise * 120, 20, 60))
    gamma = np.clip(0.96 - noise * 0.25, 0.88, 0.98)

    return sigma, k_sigma, epsilon, phi, gamma


def remove_small_components(binary_image):
    foreground = np.uint8(binary_image == 0)
    component_count, labels, stats, _ = cv2.connectedComponentsWithStats(
        foreground, connectivity=8
    )

    # minimum_area = int(np.clip(binary_image.size * 0.00001, 8, 500)) #old code
    minimum_area = int(np.clip(binary_image.size * 0.00015, 50, 2000))

    cleaned = np.full_like(binary_image, 255)
    for component in range(1, component_count):
        area = stats[component, cv2.CC_STAT_AREA]
        if area >= minimum_area:
            cleaned[labels == component] = 0
    return cleaned


def preprocess_image(
    raw_image, sigma=None, k_sigma=None, epsilon=None, phi=None, gamma=None
):
    if raw_image.ndim == 3:
        gray = cv2.cvtColor(raw_image, cv2.COLOR_BGR2GRAY)
    else:
        gray = raw_image.copy()

    smoothed = cv2.bilateralFilter(gray, d=9, sigmaColor=75, sigmaSpace=75)

    if (
        sigma is None
        or k_sigma is None
        or epsilon is None
        or phi is None
        or gamma is None
    ):
        auto = automatic_parameters(smoothed)
        sigma = auto[0] if sigma is None else sigma
        k_sigma = auto[1] if k_sigma is None else k_sigma
        epsilon = auto[2] if epsilon is None else epsilon
        phi = auto[3] if phi is None else phi
        gamma = auto[4] if gamma is None else gamma

    xdog_output = xdog_filter(
        smoothed,
        sigma=sigma,
        k_sigma=k_sigma,
        epsilon=epsilon,
        phi=phi,
        gamma=gamma,
    )

    _, binary_sketch = cv2.threshold(
        xdog_output, 0, 255, cv2.THRESH_BINARY + cv2.THRESH_OTSU
    )

    binary_sketch = remove_small_components(binary_sketch)
    return binary_sketch


def extract_smoothed_contours(binary_image):
    inverted_binary = cv2.bitwise_not(binary_image)
    contours, _ = cv2.findContours(
        inverted_binary, cv2.RETR_LIST, cv2.CHAIN_APPROX_NONE
    )
    paths = []
    for cnt in contours:
        cnt = cnt.squeeze()
        if cnt.ndim < 2:
            continue

        arc_len = cv2.arcLength(cnt, closed=False)

        if arc_len < MIN_CONTOUR_ARC_LEN:
            continue

        diffs = np.diff(cnt, axis=0)
        mask = np.any(diffs != 0, axis=1)

        cnt = cnt[np.append([True], mask)]
        if len(cnt) < MIN_CONTOUR_POINTS:
            continue

        poly_approx = cv2.approxPolyDP(
            cnt.astype(np.float32), APPROX_POLY_EPSILON, closed=False
        ).squeeze()

        if poly_approx.ndim < 2 or len(poly_approx) < 3:
            poly_approx = cnt

        x = poly_approx[:, 0]
        y = poly_approx[:, 1]

        try:
            is_closed = (
                np.linalg.norm(poly_approx[0] - poly_approx[-1]) < 3.0
            )
            spline_order = min(3, len(poly_approx) - 1)
            tck, u = splprep(
                [x, y], s=SPLINE_SMOOTHING, k=spline_order, per=is_closed
            )
            num_points = max(8, int(arc_len * 0.4))
            u_new = np.linspace(u.min(), u.max(), num_points)
            x_new, y_new = splev(u_new, tck)
            smooth_approx = np.vstack((x_new, y_new)).T
        except Exception:
            smooth_approx = poly_approx.astype(float)

        x_bound, y_bound, _, _ = cv2.boundingRect(
            smooth_approx.astype(np.int32)
        )

        paths.append({
            "points": smooth_approx,
            "y": y_bound,
            "x": x_bound,
            "is_hatch": False,
        })

    return paths


def generate_hatching_paths(binary_image, step=4):
    kernel = np.ones((3, 3), np.uint8)
    eroded_foreground = cv2.dilate(binary_image, kernel, iterations=1)

    h, w = eroded_foreground.shape
    paths = []
    current_path = []

    for i, y in enumerate(range(0, h, step)):
        row = eroded_foreground[y, :]

        is_zero = (row == 0).astype(int)
        diff = np.diff(np.concatenate(([0], is_zero, [0])))
        starts = np.where(diff == 1)[0]
        ends = np.where(diff == -1)[0] - 1

        segments = list(zip(starts, ends))
        if not segments:
            continue

        if i % 2 == 1:
            segments = reversed(segments)

        for start, end in segments:
            if end - start < 2:
                continue

            if i % 2 == 0:
                if (
                    current_path
                    and np.hypot(
                        current_path[-1][0] - start, current_path[-1][1] - y
                    )
                    > step * 3
                ):
                    if len(current_path) > 1:
                        paths.append(np.array(current_path))
                    current_path = []
                current_path.append([start, y])
                current_path.append([end, y])
            else:
                if (
                    current_path
                    and np.hypot(
                        current_path[-1][0] - end, current_path[-1][1] - y
                    )
                    > step * 3
                ):
                    if len(current_path) > 1:
                        paths.append(np.array(current_path))
                    current_path = []
                current_path.append([end, y])
                current_path.append([start, y])

    if len(current_path) > 1:
        paths.append(np.array(current_path))

    formatted_paths = []
    for p in paths:
        if len(p) >= 2:
            p_array = np.array(p, dtype=np.float32)
            
            # Calculate the total physical length of this hatch path
            dx = np.diff(p_array[:, 0])
            dy = np.diff(p_array[:, 1])
            path_length = np.sum(np.hypot(dx, dy))
            
            if path_length < (step * 5.0):
                continue
                
            x_bound, y_bound, _, _ = cv2.boundingRect(
                np.array(p, dtype=np.int32)
            )
            formatted_paths.append({
                "points": p_array,
                "y": y_bound,
                "x": x_bound,
                "is_hatch": True,
            })

    return formatted_paths


def map_paths_to_workspace(paths, image_shape):
    paths = sorted(paths, key=lambda p: (p["y"], p["x"]))

    h, w = image_shape[:2]
    scale = min(TARGET_CANVAS_W / w, TARGET_CANVAS_H / h)
    mapped_paths = []
    for p_dict in paths:
        p = p_dict["points"].astype(float)
        mapped = []
        for point in p:
            cx_img = point[0] - (w / 2.0)
            cy_img = point[1] - (h / 2.0)
            mapped.append((
                CANVAS_CENTER_X + (cx_img * scale),
                CANVAS_CENTER_Y - (cy_img * scale),
            ))

        if len(mapped) > 2 and np.hypot(
            mapped[0][0] - mapped[-1][0], mapped[0][1] - mapped[-1][1]
        ) < (3.0 * scale):
            mapped.append(mapped[0])

        mapped_path_obj = AnnotatedPath(
            mapped, is_hatch=p_dict.get("is_hatch", False)
        )
        mapped_paths.append(mapped_path_obj)

    return mapped_paths


def image_to_robot_paths(
    raw_image, sigma=None, k_sigma=None, epsilon=None, phi=None, gamma=None
):
    binary_image = preprocess_image(
        raw_image,
        sigma=sigma,
        k_sigma=k_sigma,
        epsilon=epsilon,
        phi=phi,
        gamma=gamma,
    )
    
    # 1. Recreate the hatching mask (shrinks the black foreground by 1 pixel)
    kernel = np.ones((3, 3), np.uint8)
    hatch_regions = cv2.dilate(binary_image, kernel, iterations=1)
    
    # 2. Create a specific image for contours where hatched interiors are whited out
    contour_image = binary_image.copy()
    contour_image[hatch_regions == 0] = 255
    
    # 3. Extract contours from the masked image, but generate hatches from the original
    paths = extract_smoothed_contours(contour_image)
    hatch_paths = generate_hatching_paths(binary_image, step=4)
    paths.extend(hatch_paths)
    
    return map_paths_to_workspace(paths, raw_image.shape)
