RoboticsClubIITJ/painting-arm/(commit log)

2026-06-23 Implement forward kinematics visualizer for robotic arm
2026-06-23 Implement forward kinematics visualization for robotic arm
2026-06-23 Add DH transformation matrix calculation script
    This script calculates the transformation matrices for a robotic arm using Denavit-Hartenberg parameters and outputs the end effector's position and orientation.
2026-06-23 forward kinematics solver with added GUI
2026-07-13 Add inverse kinematics for 3-link manipulator
    Implements inverse kinematics for a 3-link planar manipulator, calculating joint angles based on desired end-effector position and orientation.
2026-07-13 Add Jacobian-based IK implementation
    Implement inverse kinematics using Jacobian method for a robotic arm.
2026-07-13 Implement inverse kinematics using algebraic method
2026-07-13 Add inverse kinematics using gradient descent
    Implements inverse kinematics for a 3-link planar manipulator using gradient descent. Includes forward kinematics, Jacobian computation, and user input for link lengths and initial angles.
2026-07-13 Add inverse kinematics solver in Nayasha_jacobianpseudo.py
2026-08-07 final simulation prototype1
2026-08-09 almost smooth velocity
2026-08-11 final code
    Implement a 3-DOF robotic drawing application with GUI, kinematics, and trajectory generation.
2026-08-30 Calibration v1
2026-08-31 Calibration cleanup
2026-09-03 Add calibration and control for robotic arm
    This script initializes and calibrates a robotic arm, enabling extended position control and defining safety limits. It includes functions for reading and writing positions, moving to target coordinates, and executing paths based on image input.
2026-09-03 Add configuration parameters for 3-DOF drawing arm
2026-09-03 Add continuous trajectory generation function
    Implement continuous trajectory generation respecting kinematic limits.
2026-09-03 Integrate Arduino Nano for pen control
    Added NanoPenController for Arduino integration to control pen up/down actions. Updated GUI and drawing logic to incorporate physical pen movements.
2026-09-03 Implement forward kinematics and inverse kinematics functions
2026-09-03 Successfully reverted back to c473d69
    [Calibration.py, Configuration.py, Configurations.py, Kinematics.py, Pen_up_down.py, Trajectory.py, cv.py, gui.py]
2026-09-27 Update current_drawing.json
    cleared json
2026-09-27 Added failsafe for motor power off
    [Calibration.py]
2026-10-04 Assembly and STL files of Arm added
    [BoBRoss Assembly.f3z, BoBRoss Assembly.step, Servo_head_xm430.stl, base2.stl, end effector.stl, link1.stl, link2p1.stl, link2p2.stl]
